IEEE-NITK/Smart-Heater/WhatsApp Image 2020-08-12 at 1.12.44 PM.jpeg

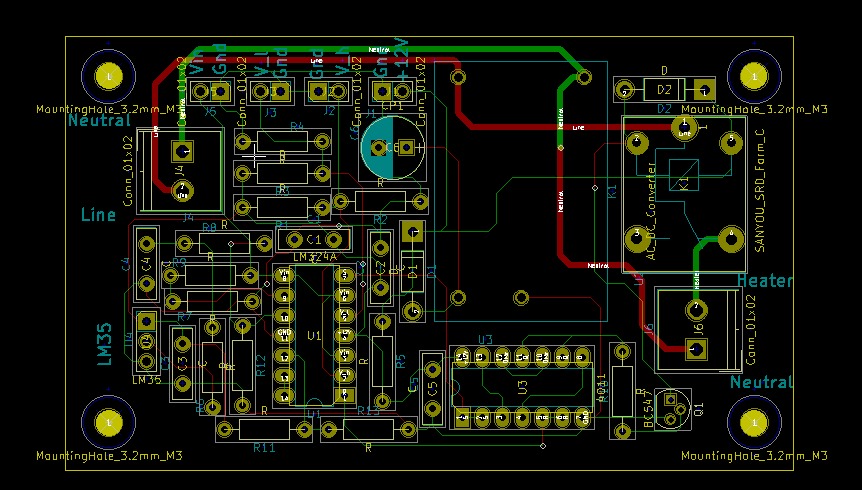
WhatsApp Image 2020-08-12 at 1.12.44 PM.jpeg
