IEEE-NITK/Smart-Heater/Final look.jpeg

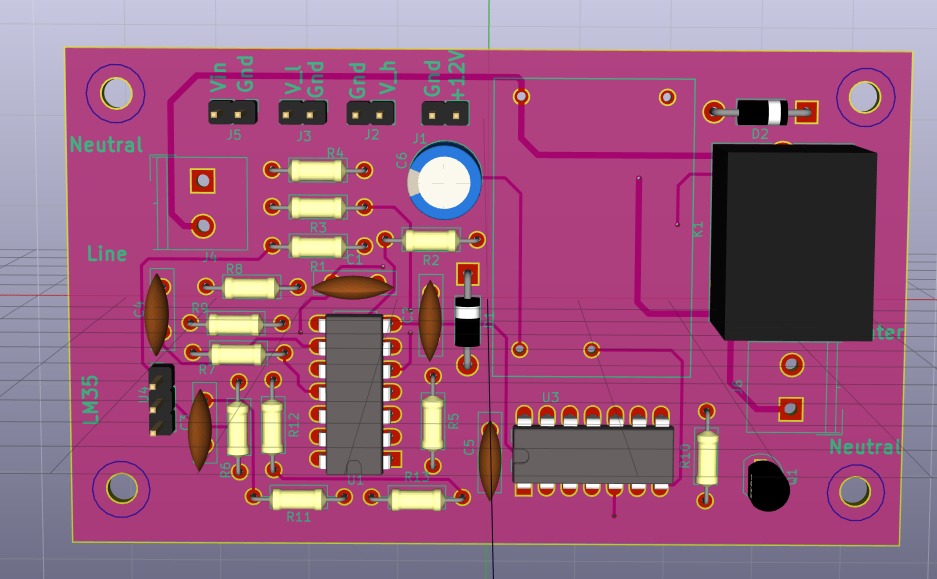
Final look.jpeg
