IEEE-NITK/Smart-Heater/README.md

# Smart-Heater
A novel device to link with a water heater to control the temprature of water and keep it between certain desirable levels.
