IEEE-NITK/Smart-Heater/Smart_Heater_Schematic.pdf

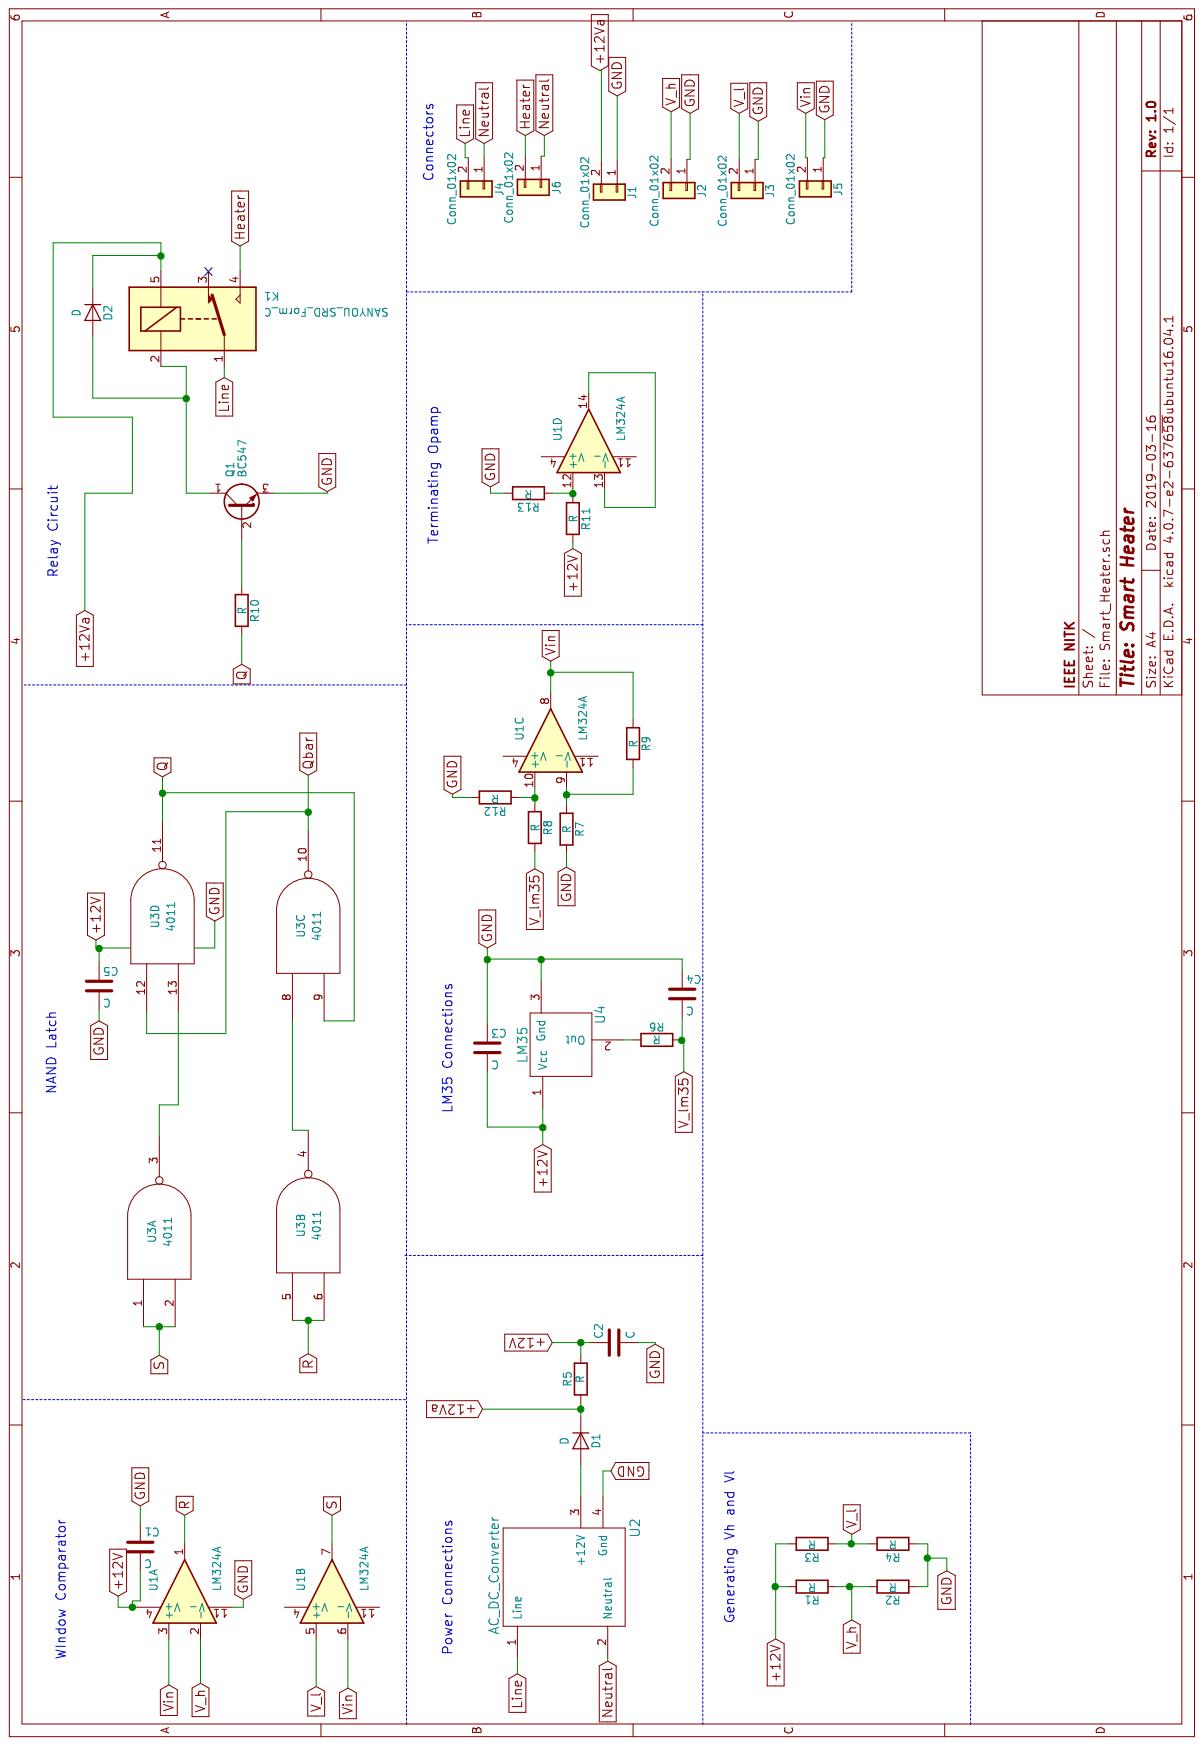
[picture p6: page 1]
