IEEE-NITK/Smart-Heater/Smart_Heater/Smart_Heater.kicad_pcb

## KiCad design Smart_Heater/Smart_Heater.kicad_pcb (2020-08-12)

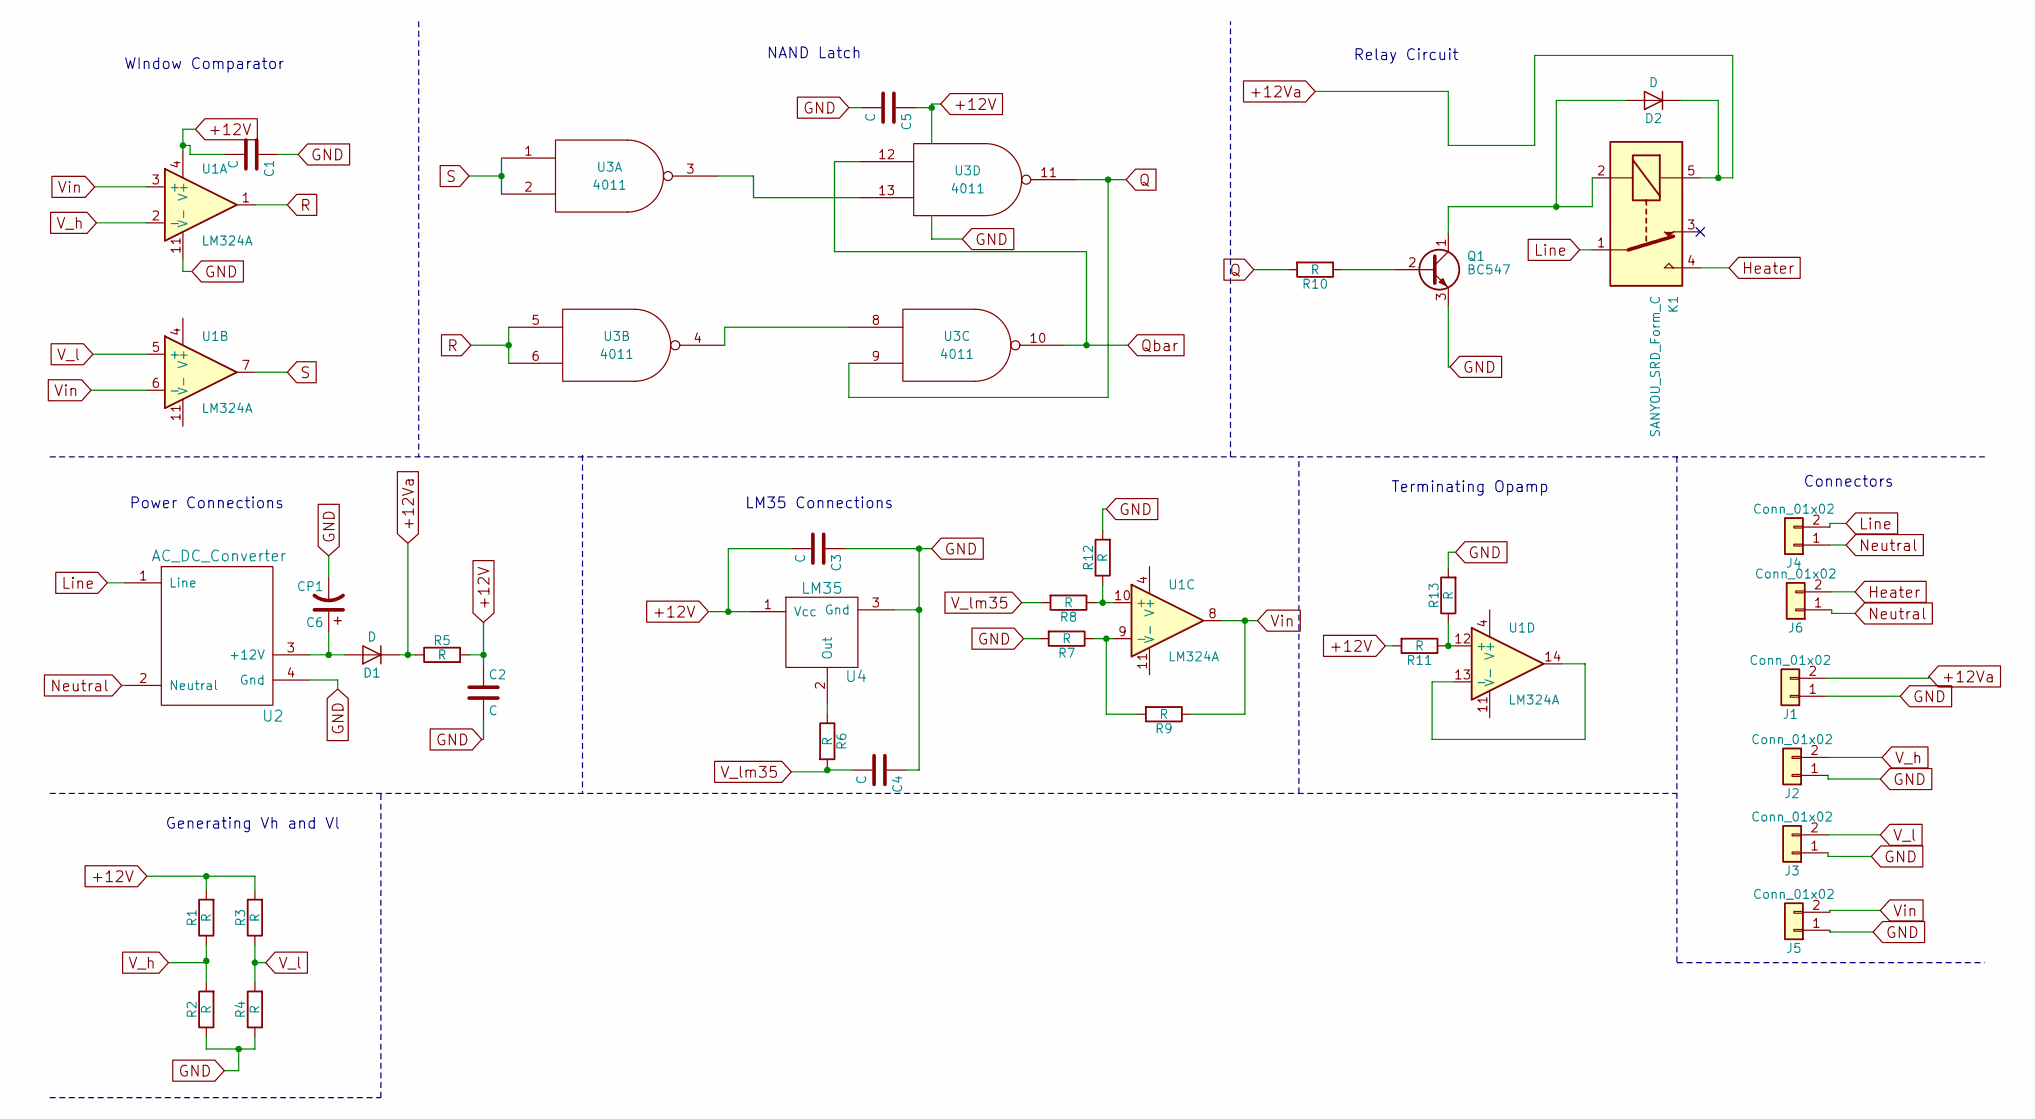
[picture p7: schematic Smart_Heater.sch, Smart Heater]

Parts:
C1, C2, C3, C4, C5: C; C_Disc_D9.0mm_W2.5mm_P5.00mm
C6: CP1; CP_Radial_D8.0mm_P3.50mm
D1, D2: D; D_DO-41_SOD81_P10.16mm_Horizontal
J1, J2, J3, J5: Conn_01x02; Pin_Header_Straight_1x02_Pitch2.54mm
J4, J6: Conn_01x02; TerminalBlock_Philmore_TB132_02x5mm_Straight
K1: SANYOU_SRD_Form_C; Relay_SPDT_SANYOU_SRD_Series_Form_C
Q1: BC547; TO-92_Molded_Narrow
R1, R2, R3, R4, R5, R6, R7, R8, R9, R10, R11, R12, R13: R; R_Axial_DIN0207_L6.3mm_D2.5mm_P10.16mm_Horizontal
U1: LM324A; DIP-14_W7.62mm_LongPads
U2: AC_DC_Converter; Combicon_Connector
U3: 4011; DIP-14_W7.62mm_LongPads
U4: LM35; Pin_Header_Straight_1x03_Pitch2.54mm

Connections:
+12V: C1.2, C2.1, C3.2, C5.1, R1.2, R3.2, R5.2, R11.2, U1.4 (V+), U3.14 (VDD), U4.1 (Vcc)
+12Va: D1.1 (K), D2.1 (K), J1.2, K1.5, R5.1
GND: C1.1, C2.2, C3.1, C4.1, C5.2, C6.2, J1.1, J2.1, J3.1, J5.1, Q1.3 (E), R2.1, R4.1, R7.2, R12.2, R13.2, U1.11 (V-), U2.4 (Gnd), U3.7 (VSS), U4.3 (Gnd)
Heater: J6.2, K1.4
Line: J4.2, K1.1, U2.1 (Line)
unnamed: C6.1, D1.2 (A), U2.3 (+12V)
unnamed: D2.2 (A), K1.2, Q1.1 (C)
unnamed: Q1.2 (B), R10.1
unnamed: R6.1, U4.2 (Out)
unnamed: R7.1, R9.2, U1.9 (-)
unnamed: R11.1, R13.1, U1.12 (+)
unnamed: R8.1, R12.1, U1.10 (+)
unnamed: U1.13 (-), U1.14
unnamed: U3.4, U3.8
unnamed: U3.3, U3.13
Neutral: J4.1, J6.1, U2.2 (Neutral)
Q: R10.2, U3.9, U3.11
Qbar: U3.10, U3.12
R: U1.1, U3.5, U3.6
S: U1.7, U3.1, U3.2
V_h: J2.2, R1.1, R2.2, U1.2 (-)
V_l: J3.2, R3.1, R4.2, U1.5 (+)
V_lm35: C4.2, R6.2, R8.2
Vin: J5.2, R9.1, U1.3 (+), U1.6 (-), U1.8

Notes on the sheet:
WIndow Comparator
NAND Latch
Relay Circuit
LM35 Connections
Power Connections
Connectors
Terminating Opamp
Generating Vh and Vl

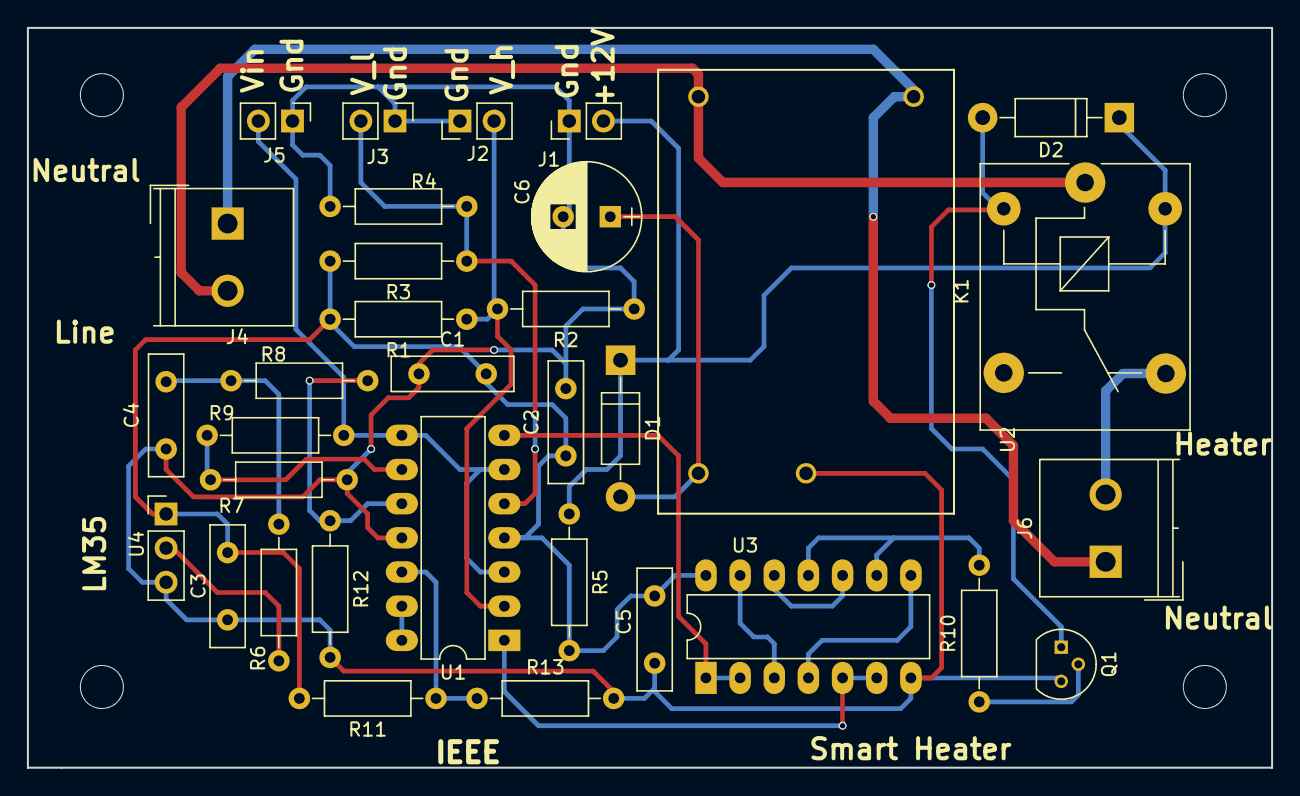
[picture p8: board Smart_Heater.kicad_pcb from above]

Board: 2 copper layers, 92.5 x 55.0 mm, 33 parts (0 on the bottom side), 24 nets.
